Psychu-Engineering/Guide-To-High-Altitude-Ballooning/G0010326 copy.jpg

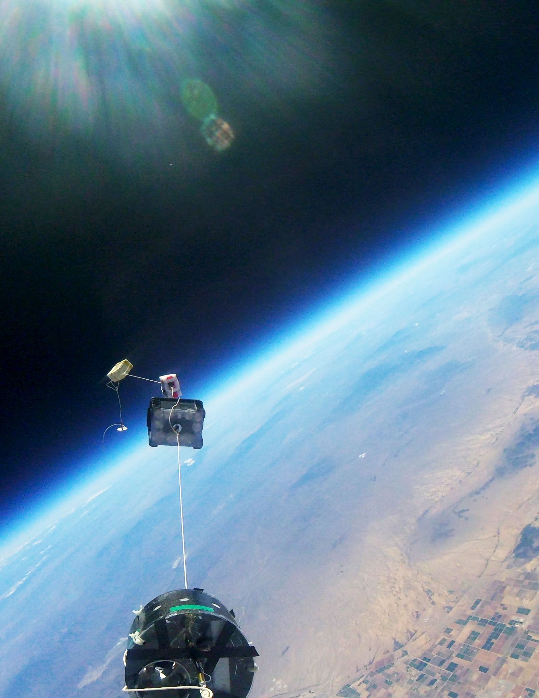
G0010326 copy.jpg
