Psychu-Engineering/Guide-To-High-Altitude-Ballooning/README.md

# Guide-To-High-Altitude-Ballooning
Where I keep stuff that could be useful in HAB
