Psychu-Engineering/Guide-To-High-Altitude-Ballooning/Basics of Payload Design Schedule.pdf

Basics of Payload Design for Academic Ballooning: A High Altitude Journey

Kit
Total | $47.35 | | Participants will be expected to attend workshop using their own personal computer and will be expected to download and install a predefined set of applications and files on their computer prior to the workshop sessions. Applications to install are: Arduino IDE, Eagle CAD, Glueviz with Anaconda, Atom text editor, and companion files for use during the workshop.
Part | Unit Cost | Links
Arduino budget pack | $29.95 | link (https://www.digikey.com/product-detail/en/adafruit-industries-llc/193/1528-1078-ND/5154653)
AM2320 Humidity Sensor | $3.95 | link (https://www.digikey.com/product-detail/en/adafruit-industries-llc/3721/1528-2564-ND/8558266)
MPL115A2 Barometer | $7.95 | link (https://www.digikey.com/product-detail/en/adafruit-industries-llc/992/1528-1172-ND/5353632)
Shifting MicroSd breakout | $5.50 | link (https://www.digikey.com/products/en?keywords=sparkfun%20level%20shifting%20sd)

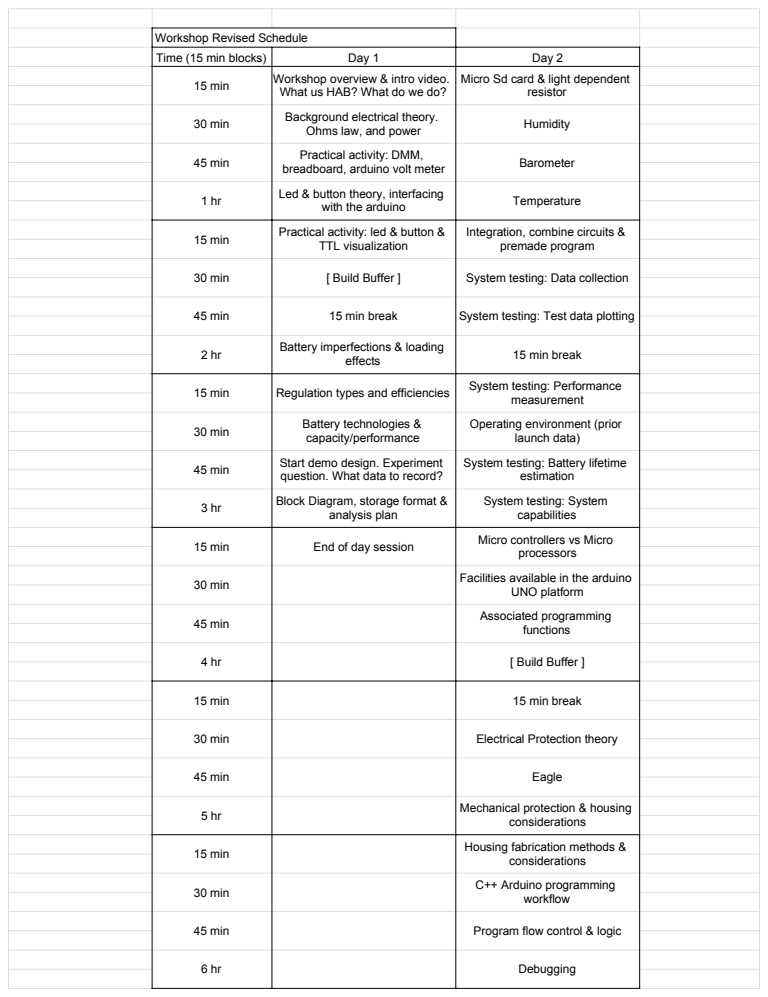
[picture p76: page 2]

Workshop Revised Schedule

Time (15 min blocks) | Day 1 | Day 2

15 min 30 min 45 min 1 hr | Workshop overview & intro video. What us HAB? What do we do? Background electrical theory. Ohms law, and power Practical activity: DMM, breadboard, arduino volt meter Led & button theory, interfacing with the arduino | Micro Sd card & light dependent resistor Humidity Barometer Temperature

15 min 30 min 45 min 2 hr | Practical activity: led & button & TTL visualization [ Build Buffer ] 15 min break Battery imperfections & loading effects | Integration, combine circuits & premade program System testing: Data collection System testing: Test data plotting 15 min break

15 min 30 min 45 min 3 hr | Regulation types and efficiencies Battery technologies & capacity/performance Start demo design. Experiment question. What data to record? Block Diagram, storage format & analysis plan | System testing: Performance measurement Operating environment (prior launch data) System testing: Battery lifetime estimation System testing: System capabilities

15 min 30 min 45 min 4 hr | End of day session | Micro controllers vs Micro processors Facilities available in the arduino UNO platform Associated programming functions [ Build Buffer ]

15 min 30 min 45 min 5 hr | | 15 min break Electrical Protection theory Eagle Mechanical protection & housing considerations

15 min 30 min 45 min 6 hr | | Housing fabrication methods & considerations C++ Arduino programming workflow Program flow control & logic Debugging
